sablintechno/O_C_T41/hardware/12HP_Panel+Expander/README.md

<h1>Front PCB</h1>
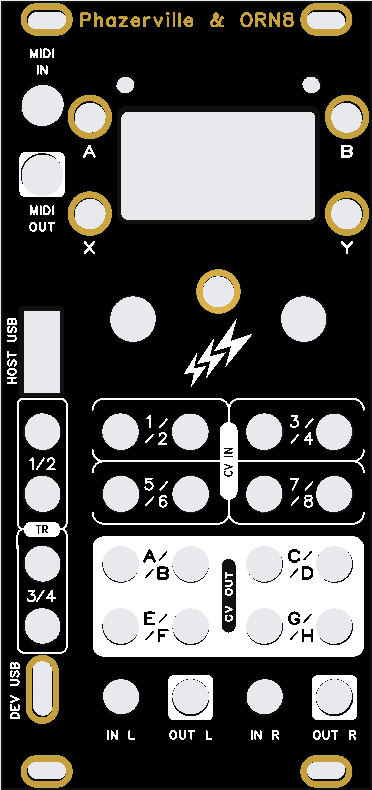
[picture p1: hardware/12HP_Panel+Expander/ornamant-crimes-o-r-n-8-phazervi.jpg]

<h1>Front</h1>
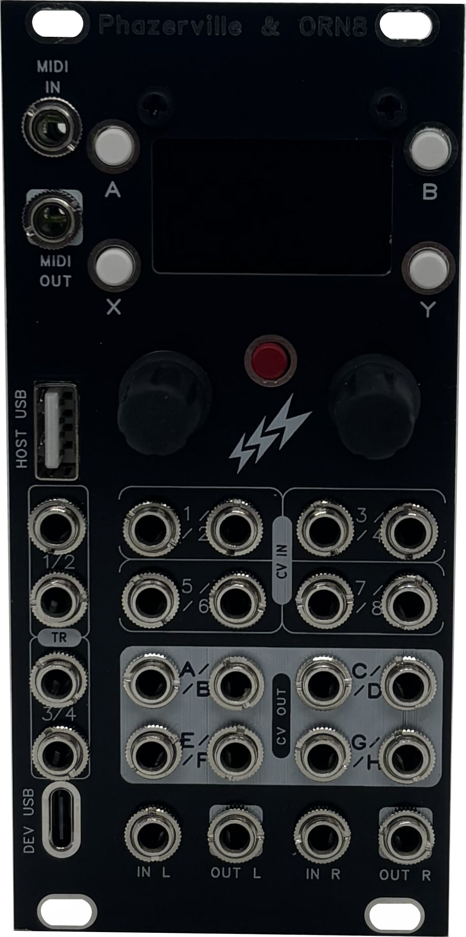
[picture p2: hardware/12HP_Panel+Expander/Pic_Front.png]

<h1>Side</h1>
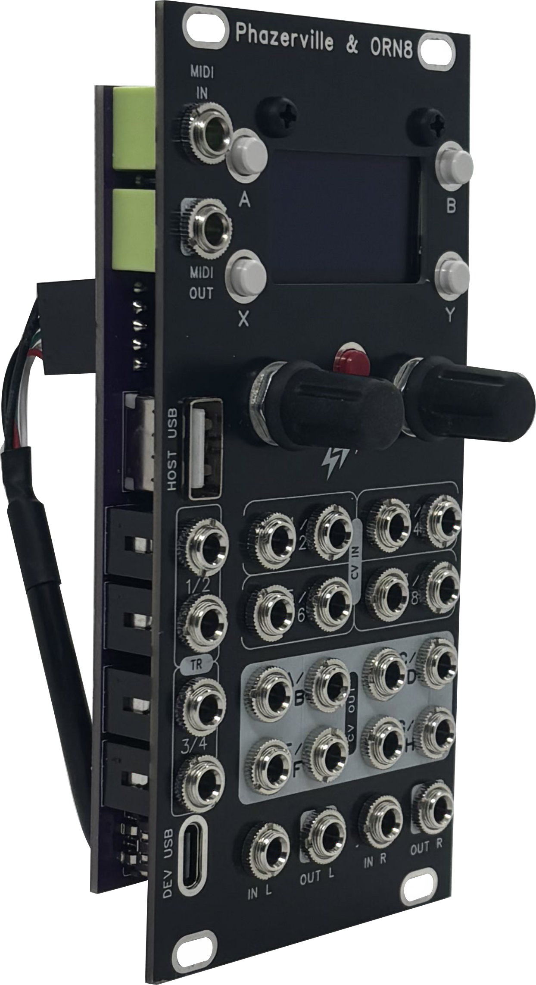
[picture p3: hardware/12HP_Panel+Expander/Pic_Side.png]
