sablintechno/O_C_T41/hardware/12HP_Panel+Expander/RM_O_C_T41_bottom_analog_bom.xlsx

Comment | Designator | Footprint | LCSC Part # |  | Original Part
22pF | C34, C35, C36, C37, C38, C39, C40, C41 | 0805 | C1804 | CL21C220JBANNNC | C105623 | CC0805JRNPO9BN220
47pF | C46, C47 | 0805 | C14857 | CL21C470JBANNNC | C107118 | CC0805JRNPO9BN470
470pF | C18, C19, C20, C21, C22, C23, C24, C25 | 0805 | C1822 | 0805CG471J500NT | C62771 | CC0805JRNPO9BN471
1nF | C44, C45 | 0805 | C1791 | CL21C102JBCNNNC | C16195506 | CL21C102JBCNFNC
8.2nF | C42, C43 | 0805 | C576998 | CC0805JRX7R0BB822 | C17348613 | GRM2195C2A822JA01D
10nF |  | 0805 | C24666 | 0805B103J500NT | C58456 | CC0805JRX7R9BB103
DNP | C2, C3, C4, C5, C6, C7, C8, C9, C10, C11, C12
0.1uF | C13, C14, C15, C16, C17, C26, C27, C28, C29, C30, C31, C32, C33 | 0805 | C29926 | 0805B104J500NT | C111492 | CC0805JRX7R9BB104
1.0uF | C1,C50, C51 | 0805 | C541528 | CC0805JKX7R9BB105 | C541528 | CC0805JKX7R9BB105
10uF | C48, C49 | 0805 | C15850 | CL21A106KAYNNNE | C307520 | CL21A106KOQNNNG
220 | R59, R60, R61, R62, R63, R64, R65, R66, R83, R84, R85, R86, R87, R88, R89, R90, R91, R92 | 0805 | C17557 | 0805W8F2200T5E | C114519 | RC0805FR-07220RL
470 | R17, R18, R19, R20, R21, R22, R9, R6, R10, R7, R8 | 0805 | C17710 | 0805W8F4700T5E | C114564 | RC0805FR-07470RL
1.40K | R93, R94 | 0805 | C17388 | 0805W8F1401T5E | C482967 | RC0805FR-071K4L
2.21K | R95, R96 | 0805 | C17518 | 0805W8F2211T5E | C137557 | RC0805FR-072K21L
3.48K | R97, R98 | 0805 | C72936 | 0805W8F3481T5E | C274007 | RC0805FR-073K48L
4.7K | R1, R2, R3, R4, R5, R11, R12, R13, R14, R15, R16, R23, R24, R25, R26 | 0805 | C17673 | 0805W8F4701T5E | C60816 | RC0805FR-074K7L
12k1 | R67, R68, R69, R70, R71, R72, R73, R74 | 0805 | C515725 | ARG05BTC2492 | C865327 | RT0805BRD0724K9L | mod DAC
20k | R101, R102 | 0805 | C17623 | 0805W8F3162T5E | C483116 | RC0805FR-0731K6L | mod input
49.9K | R51, R52, R53, R54, R55, R56, R57, R58 | 0805 | C469661 | RT0805BRD0749K9L | C469661 | RT0805BRD0749K9L
75K 1% | R43, R44, R45, R46, R47, R48, R49, R50 | 0805 | C136919 | RT0805BRD0775KL | C136919 | RT0805BRD0775KL
100K 1% | R27, R28, R29, R30, R99, R100 | 0805 | C149504 | 0805W8F1003T5E | C96346 | RC0805FR-07100KL
100K 0,1% | R35, R36, R37, R38, R39, R40, R41, R42, R75, R76, R77, R78, R79, R80, R81, R82 | 0805 | C56453 | TC0525B1003T5E | C122537 | RT0805BRD07100KL
1M | R31, R32, R33, R34 |  | C17514 | 0805W8F1004T5E | C107700 | RC0805FR-071ML
Voltage | U1 | SOIC14 | C74559 | LM339ADR | C74559 | LM339ADR
Dual | U2, U3, U4, U5 | SOIC8 | C116706 | MCP6002-I/SN | C116706 | MCP6002-I/SN
Dual | U6, U7, U8, U9 | SOIC8 | C545167 | OPA2172IDR | C545167 | OPA2172IDR
Dual | U10 | SOIC8 | C34047 | MCP6022-I/SN | C34047 | MCP6022-I/SN
Dual | U11 | SOIC8 | C2860714 | LM833DR | C2860714 | LM833DR
Optocoupler | U27 | DIP6 | C78588 | H11L1 | C78588 | H11L1
100K 1% | R105, R106, R107, R108 | 0805 | C149504 | 0805W8F1003T5E | C96346 | RC0805FR-07100KL
4.7K | R103, R104 | 0805 | C17673 | 0805W8F4701T5E | C60816 | RC0805FR-074K7L
J22, J23 | 2 | 7x2 | SLW-107-01-T-S |  | zu flach
J1-J20 | 20 | Jack, mono 3.5mm | PJ-301M
J21 | 1 | OLED Display, 1.3 inch, 7 Pin, 128 x 64 px
J26-J27 | 2 | Header, 16x1 | SLW-116-01-T-S
SW1-SW5 | 5 | Pushbutton | TL1105SPF100Q
 |  | Cap | 1RLGR
SW6-SW7 | 2 | Rotary Encoder | PEC11R-4220K-S0024, T18 | PEC11R-4220F-S0024, D-Shaft
 | 2 | 24 pin headers | PPTC241LFBN-RC
 | 2 | 24 pin sockets - CRITICAL: USE A SOCKET so Teensy is replaceable!
Optionales RAM Update Teensy
APS6404L_3SQR | IC, optional PSRAM, https://www.pjrc.com/store/psram.html
IS66WVS16M8FBLL-104NLI
