sablintechno/O_C_T41/hardware/12HP_Panel+Expander/RM_O_C_T41_bottom_control_bom.xlsx

Comment | Designator | Footprint | LCSC Part # |  |  | Original Part
22pF | C92 | 0805 | C1804 | CL21C220JBANNNC | C105623 | CC0805JRNPO9BN220
 | C81, C82, C83, C84, C85, C86, C87, C88, C89, C90 | 0805 | C1835 | 0805CG681J500NT | C107121 | CC0805JRNPO9BN681
10nF | C91 | 0805 | C24666 | 0805B103J500NT | C58456 | CC0805JRX7R9BB103
1.0uF | C69, C70, C71, C72, C73 | 0805 | C541528 | CC0805JKX7R9BB105 | C541528 | CC0805JKX7R9BB105
0.1uF | C52, C53, C54, C55, C56, C57, C58, C59, C60, C61, C62, C63, C64, C65, C66, C67, C68, C94 | 0805 | C29926 | 0805B104J500NT | C111492 | CC0805JRX7R9BB104
10uF | C74, C75, C76, C77, C78, C79, C80 | 0805 | C15850 | CL21A106KAYNNNE | C307520 | CL21A106KOQNNNG
10uF | C93 | 1206 | C7171 | TAJA106K016RNJ | C7171 | TAJA106K016RNJ
22uF | C95, C96, C97 | 1206 | C12891 | CL31A226KAHNNNE | C12891 | CL31A226KAHNNNE
Bridge Rectifier | D1 | TO-269AA | C52151 | HD01-T | C52151 | HD01-T
Diode Zener | D2, D3, D4 |  | C142361 | 1SMB5918BT3G | C142361 | 1SMB5918BT3G
Diode | D5 | SDO123 | C77978 | 1N4148W-TP | C77978 | 1N4148W-TP
Diode | D6 | SDO123 |  |  |  | BZT52B5V1S | mod 5V
PTC Fuse | F1 | 1812 | C12430 | MF-MSMF010-2 | C12430 | MF-MSMF010-2
Ferrite Bead | L1 | 0805 | C2441364 | HZ0805E601R-10 | C2441364 | HZ0805E601R-10
Inductor | L2 |  | C2921170 | BCIHP0420SC-100M | C2921170 | BCIHP0420SC-100M | LQH44NN100K03L | LQH44PH100MPRL | CY43-10UH | MDA4020-100M | IFSC1515AHER100M01
Inductor | L3 | 0805 | C223145 | BRC2012T1R5MD | C223145 | BRC2012T1R5MD
Mosfet | Q1, Q2 | SOT23 | C80498 | FDV303N | C80498 | FDV303N
0 | R144 | 0805 | C17477 | 0805W8F0000T5E | C17477 | 0805W8F0000T5E
75 | R141, R142, R143 | 1206 | C17987 | 1206W4F750JT5E | C4185489 | CRCW120675R0FKEAC
120 | R139, R140 | 1206 |  |  |  |  | mod 5V
100 | R103, R104, R105, R106, R107, R108, R109, R110, R111, R112, R113, R114, R115, R116, R117 | 0805 | C17408 | 0805W8F1000T5E | C105577 | RC0805FR-07100RL
220 | R118 | 0805 | C17557 | 0805W8F2200T5E | C114519 | RC0805FR-07220RL
470 | R119 | 0805 | C17710 | 0805W8F4700T5E | C114564 | RC0805FR-07470RL
1K | R131, R132 | 0603 | C21190 | 0603WAF1001T5E | C22548 | RC0603FR-071KL
5.11K 1% | R126 | 0805 | C46039 | 0805W8F5111T5E | C276311 | RC0805FR-075K11L
10K 0,005% | R133, R134, R135, R136, R137 | 0805 | C706400 | RT0805WRD0710KL | C2073470 | ERA-6ARW103V
4k7 | R133 | 0805 |  |  |  |  | mod DAC
5k8 | R134 | 0805 |  |  |  |  | mod DAC
4.7K 1% | R121, R123, R124, R120, R122 | 0805 | C17673 | 0805W8F4701T5E | C60816 | RC0805FR-074K7L
11K | R125 | 0805 | C17429 | 0805W8F1102T5E | C137597 | RC0805FR-0711KL
20K 0,05% | R138 | 0805 | C706402 | RT0805WRD0720KL | C4141407 | ERA-6ARW203V | AR05ATB2002 | PTFR0805Q20K0N9
22K | R128 | 0805 | C17560 | 0805W8F2202T5E | C114565 | RC0805FR-0722KL
27k | R127 | 0805 |  |  |  |  | mod 5V
150K 1% | R129 | 0805 | C17470 | 0805W8F1503T5E | C114558 | RC0805FR-07150KL
100K 1% | R130 | 0805 |  |  |  |  | mod HW
DNP | R200, R201, R202
Buck Converter | U13 | SOT-23-6 | C3193129 | LMR54406FDBVR | C3193129 | LMR54406FDBVR
LDO 5V | U14 | SOT-23-5 | C37560592 | LP2985A-50DBVRM3 | C37560592 | LP2985A-50DBVRM3 | LP2985-50DBVR
LDO 3.3V | U15 | SOT-23-5 | C2862740 | TPS7A2033PDBVR | C2862740 | TPS7A2033PDBVR
LDO 1.8V | U16 | SOT-23-5 | C92498 | LP5907MFX-1.8/NOPB | C92498 | LP5907MFX-1.8/NOPB
ADC | U17 | MSOP-10 | C635977 | MCP33131D-05-E/MS | C635977 | MCP33131D-05-E/MS
analog mux | U18 | TSSOP-16 | C547982 | 74LV4051PW,118 | C547982 | 74LV4051PW,118
DAC | U19 | TSSOP-16 | C2680013 | DAC8568IBPWR | C2680013 | DAC8568IBPWR
Buffer level shifter | U20, U21, U22, U23 | SOT-23-5 | C473338 | SN74LV1T125DBVR | C473338 | SN74LV1T125DBVR
Audio ADC | U24 | TSSOP-14 | C55513 | PCM1808PWR | C55513 | PCM1808PWR
Audio DAC | U25 | SSOP-16-150mil | C294211 | PCM1754DBQR | C294211 | PCM1754DBQR
Dual Opamp | U26 | SOIC-8 | C962986 | OPA2277UA | C962986 | OPA2277UA
Optocoupler | U27 | DIP6 | C78588 | H11L1 | C78588 | H11L1 | H11L1SVM
J38 | 1 | Connector, JST 4 pin, Sparkfun QWIIC |  |  |  | PRT-14417
J28-J29 | 2 | Socket, 7x2 (omit if soldering boards together) |  |  |  | TSW-107-06-T-S
J30-J31 | 2 | Socket, 16x1 (omit if soldering boards together) |  |  |  | TSW-116-06-T-S
J32 | 1 | Header, 5x2 Shrouded |  |  |  | 68015-405HLF
J33 | 1 | Header, 4x1 |  |  |  | 68000-204HLF
J34-J35 | 2 | Header, 2x1 (omit if debug signals not needed)
J36-J37 | 2 | Test Point (omit if not needed) Keystone 5011
U12 | 1 | Teensy 4.1 (with headers and sockets) |  |  |  | 16996
