sablintechno/O_C_T41/(list of files, drawings)

Other design files:
hardware/12HP_Panel+Expander/RM_analog_rev3_V0.1.dip
hardware/12HP_Panel+Expander/RM_control_rev3_V0.1.dip
hardware/12HP_Panel+Expander/RM_front_rev3_V0.1.dip
