sablintechno/O_C_T41/hardware/12HP_Panel+Expander/KiCad/RM_control_rev3_V0.1.kicad_pcb

## KiCad design hardware/12HP_Panel+Expander/KiCad/RM_control_rev3_V0.1.kicad_pcb (2026-06-14)

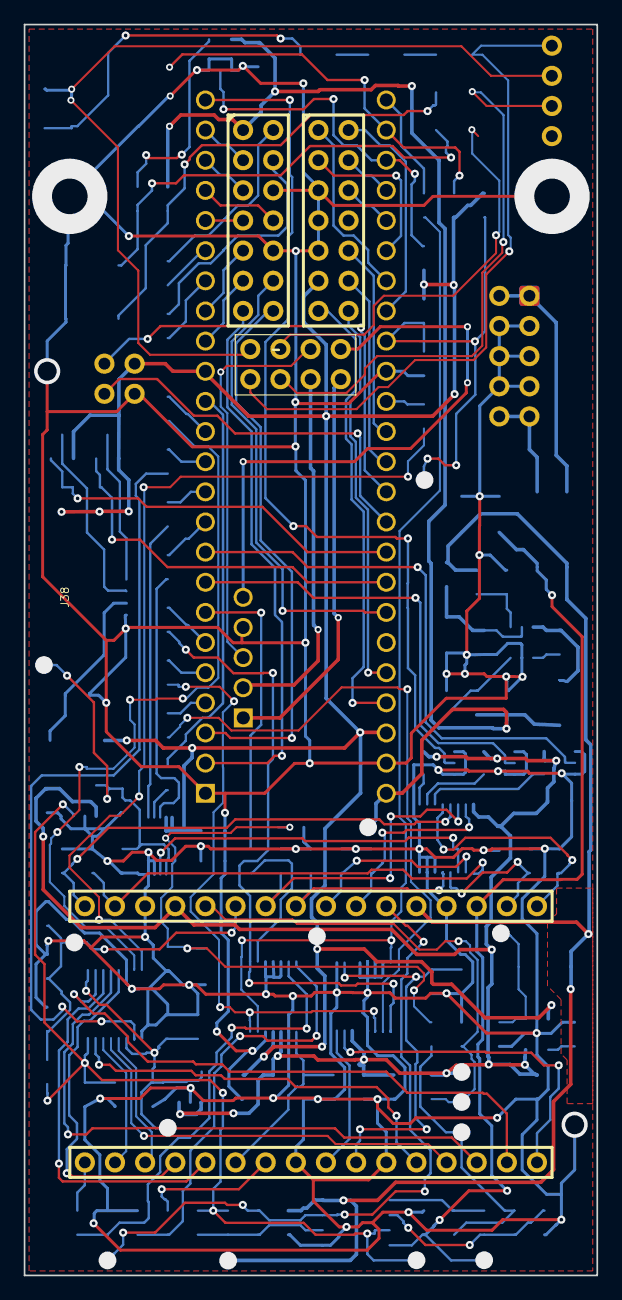
[picture p4: board RM_control_rev3_V0.1.kicad_pcb from above]

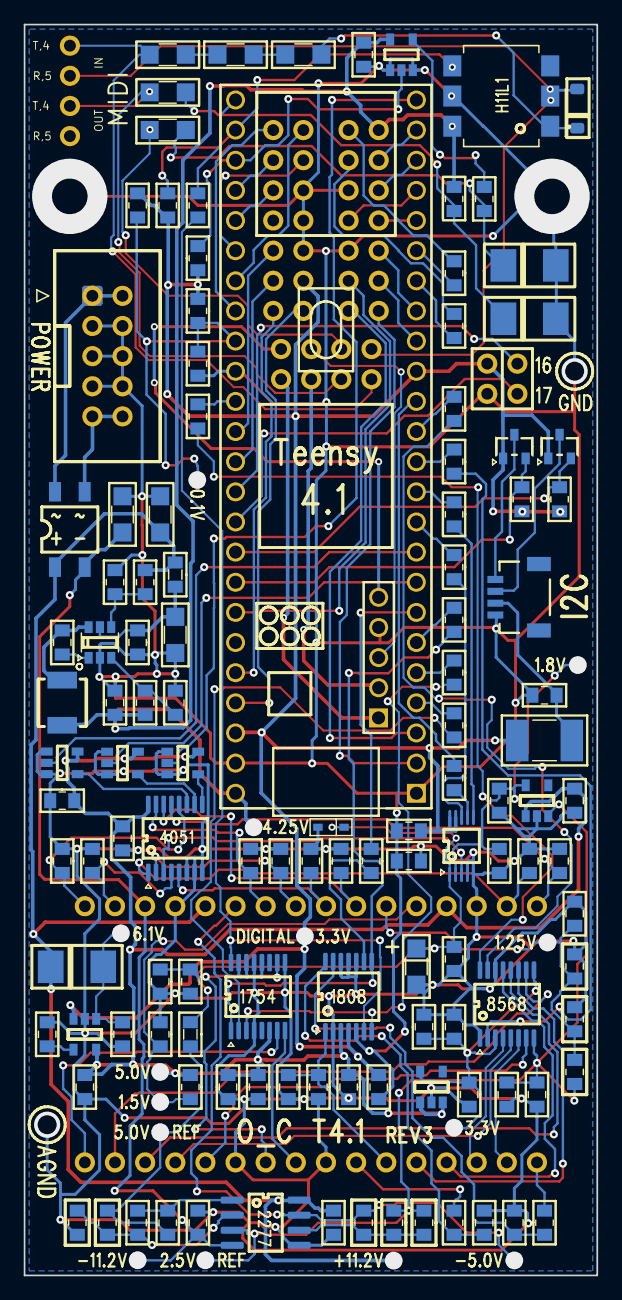
[picture p5: board RM_control_rev3_V0.1.kicad_pcb from below]

Board: 2 copper layers, 48.3 x 105.4 mm, 128 parts (2 on the bottom side), 126 nets.

Parts:
C52, C54, C57, C60, C61, C71, C73, C74, C81, C82, C83, C84, C85, C86, C87, C88, C89, C90, C91, C92: C_0805_2012METRIC_PAD1.18X1.45MM_HANDSOLDER_RECTP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; C_0805_2012Metric_Pad1.18x1.45mm_HandSolder_rectpads
C53, C55, C56, C58, C59, C62, C63, C64, C65, C66, C67, C68, C69, C70, C72, C75, C76, C77, C78, C79, C80, C94: C_0805_2012METRIC_PAD1.18X1.45MM_HANDSOLDER_RECTP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; C_0805_2012Metric_Pad1.18x1.45mm_HandSolder_rectpads_C53
C93, C97: C_1206_3216METRIC_PAD1.33X1.80MM_HANDSOLDER_RECTP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; C_1206_3216Metric_Pad1.33x1.80mm_HandSolder_rectpads
C95, C96: C_1206_3216METRIC_PAD1.33X1.80MM_HANDSOLDER_RECTP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; C_1206_3216Metric_Pad1.33x1.80mm_HandSolder_rectpads_C95
D1: DIODE_BRIDGE_REDUCED; Diode_Bridge_reduced
D2, D3, D4: D_SMB_HANDSOLDERING_RECTPADS; D_SMB_Handsoldering_rectpads
D5: D_SOD-123
D6: D_SOD-323F_RECTPADS; D_SOD-323F_rectpads
F1: FUSE_1812_4532METRIC_PAD1.30X3.40MM_HANDSOLDER_RE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; Fuse_1812_4532Metric_Pad1.30x3.40mm_HandSolder_rectpads
J1: PINSOCKET_1X04_P2.54MM_VERTICAL_REDUCED; PinSocket_1x04_P2.54mm_Vertical_reduced
J28, J29: PINSOCKET_2X07_P2.54MM_VERTICAL_REDUCED; PinSocket_2x07_P2.54mm_Vertical_reduced
J30, J31: PINSOCKET_1X16_P2.54MM_VERTICAL_REDUCED; PinSocket_1x16_P2.54mm_Vertical_reduced
J32: IDC-HEADER_2X05_P2.54MM_VERTICAL_REDUCED; IDC-Header_2x05_P2.54mm_Vertical_reduced
J33: PINSOCKET_2X04_P2.54MM_VERTICAL_REDUCED; PinSocket_2x04_P2.54mm_Vertical_reduced
J34: PINHEADER_2X02_P2.54MM_VERTICAL_SYMMETRIC; PinHeader_2x02_P2.54mm_Vertical_symmetric
J38: JST_SMD_1.0MM-4; JST_SMD_1.0mm-4
L1: L_0805_2012METRIC_RECTPADS; L_0805_2012Metric_rectpads
L2: L_ABRACON_ASPI-4030S_RECTPADS; L_Abracon_ASPI-4030S_rectpads
L3: L_0805_2012METRIC_RECTPADS; L_0805_2012Metric_rectpads_L3
Q1, Q2: SOT-23-3_RECTPADS; SOT-23-3_rectpads
R103, R104, R112, R119, R120, R122, R123, R124, R126, R127, R128, R131, R132, R133, R134, R136, R137, R138, R144, R200: R_0805_2012METRIC_PAD1.20X1.40MM_HANDSOLDER_RECTP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; R_0805_2012Metric_Pad1.20x1.40mm_HandSolder_rectpads
R105, R106, R107, R108, R109, R110, R111, R113, R114, R115, R116, R117, R118, R121, R125, R129, R130, R135, R201, R202: R_0805_2012METRIC_PAD1.20X1.40MM_HANDSOLDER_RECTP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; R_0805_2012Metric_Pad1.20x1.40mm_HandSolder_rectpads_R105
R139, R140, R141, R142, R143: R_1206_3216METRIC_PAD1.30X1.75MM_HANDSOLDER_RECTP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; R_1206_3216Metric_Pad1.30x1.75mm_HandSolder_rectpads
U12: TEENSY41; Teensy41
U13: SOT-23-6_RECTPADS; SOT-23-6_rectpads
U14: SOT-23-5_REDUCEDPADS; SOT-23-5_reducedpads
U15, U16, U20, U21, U22, U23: SOT-23-5_REDUCEDPADS; SOT-23-5_reducedpads_U15
U17: MSOP-10_3X3MM_P0.5MM_SILKSCREEN+FOOTPRINT; MSOP-10_3x3mm_P0.5mm_silkscreen+footprint
U18, U19, U25: TSSOP-16_4.4X5MM_P0.65MM_SILKSCREEN; TSSOP-16_4.4x5mm_P0.65mm_silkscreen
U24: TSSOP-14_4.4X5MM_P0.65MM_SILKSCREEN; TSSOP-14_4.4x5mm_P0.65mm_silkscreen
U26: SOIC-8_3.9X4.9MM_P1.27MM_SHIFTEDPADS; SOIC-8_3.9x4.9mm_P1.27mm_shiftedpads
U27: OPTOCOUPLER_H11F3SR2M

Connections:
+3v3: C57.1, C63.1, F1.2, J28.12, J34.1, Q1.1, Q2.1, R119.1, R120.1, R122.1, R123.1, R130.1, R202.1, U12.3.3V, U12.3.3V@, U14.3, U17.9, U17.10, U24.4
+4v: C74.1, C94.1, J29.2, L2.2, R116.1, R127.1, U12.VIN, U23.5, U27.6
+5va: C54.1, C55.1, C64.1, C66.1, C70.1, C72.1, C76.1, J30.4, R125.1, U14.5, U15.1, U15.3, U16.1, U18.16, U20.5, U21.5, U22.5, U24.3, U25.6
+12va: C67.1, C95.1, D1.1, D2.1, J30.12, L1.1, R129.1, U26.8
-12va: C68.2, C96.1, D1.2, J30.14, U26.4
/adc_cs: R107.1, U12.9
/adc_miso: R112.2, U12.12
/adc_mux_a0: U12.7, U20.2
/adc_mux_a1: U12.6, U21.2
/adc_mux_a2: U12.32, U22.2
/adc_sck: R108.1, U12.8
/dac_cs: R106.1, U12.10
/dac_mosi: R105.1, U12.11
/dac_sck: R114.1, U12.13
/debug1: J34.2, U12.16
/debug2: J34.4, U12.17
/enc_l_a: J29.4, U12.31
/enc_l_b: J29.6, U12.30
/enc_l_sw: J29.12, U12.24
/enc_r_a: J28.5, U12.37
/enc_r_b: J28.3, U12.36
/enc_r_sw: J29.10, U12.25
/hw_id: R121.1, R130.2, R202.2, U12.41
/i2c_scl: Q1.2, R122.2, U12.19
/i2c_sda: Q2.2, R123.2, U12.18
/i2s_bclk: R109.1, U12.4
/i2s_data_adc: R113.1, U12.5
/i2s_data_dac: R111.1, U12.2
/i2s_lrclk: R110.1, U12.3
/i2s_mclk: R115.1, U12.33
/midi_in: R119.2, U12.34, U27.4
/midi_out: R120.2, U12.35, U23.2
/oled_cs: J28.1, U12.40
/oled_dc: J28.2, U12.39
/oled_mosi: R104.1, U12.26
/oled_rst: J28.4, U12.38
/oled_sck: R103.1, U12.27
/sw_a: J29.7, U12.29
/sw_b: J28.9, U12.14
/sw_x: J29.8, U12.28
/sw_y: J28.11, U12.15
/sw_zap: J29.11, U12.20
/tr1: J29.14, U12.0
/tr2: J29.13, U12.1
/tr3: J28.14, U12.23
/tr4: J28.13, U12.22
D+_B: J33.6, U12.D+
D-_B: J33.5, U12.D-
SHLD_B: J33.8, U12.GND@_3
VBUS_B: J33.7, U12.+5V
earth: C53.2, C57.2, C63.2, C73.2, C74.2, C94.2, C95.2, C96.2, C97.2, D3.2, D4.2, J28.6, J28.8, J28.10, J29.5, J29.9, J32.3, J32.4, J32.5, J32.6, J32.7, J32.8, J34.3, J38.1, R121.2, R126.2, R128.2, R144.1, U12.GND, U12.GND@, U12.GND@_1, U12.GND@_2, U13.2, U23.1, U23.3, U24.5, U27.5
gnd: C54.2, C55.2, C56.2, C58.2, C59.2, C60.2, C61.2, C62.2, C64.2, C65.2, C66.2, C67.2, C68.1, C69.2, C70.2, C71.2, C72.2, C75.2, C76.2, C77.2, C78.2, C79.2, C80.2, C81.2, C82.2, C83.2, C84.2, C85.2, C86.2, C87.2, C88.2, C89.2, C90.2, C91.2, C93.2, D6.2, J30.3, J30.13, J31.8, J31.11, R124.2, R133.2, R136.1, R144.2, R200.2, U14.2, U15.2, U16.2, U17.4, U17.5, U18.6, U18.7, U18.8, U19.1, U19.14, U20.1, U20.3, U21.1, U21.3, U22.1, U22.3, U24.2, U24.10, U24.11, U24.12, U25.4, U25.9, U25.12, U25.13, U25.14, U25.15, U26.5
net-(c92-pad2): C92.2, R118.1, U26.1
net-(d2-a): C69.1, D2.2, U14.1
net-(d3-k): D3.1, R117.2, R140.1
net-(d4-k): D4.1, R116.2, R139.1
net-(d5-a): D5.2, J1.2, J33.2, U27.2
net-(d5-k): D5.1, R141.1, U27.1
net-(d6-k): C59.1, C93.1, D6.1, L3.2, U17.1
net-(j29-pin_1): J29.1, R103.2
net-(j29-pin_3): J29.3, R104.2
net-(j30-pin_1): C88.1, J30.1, U18.13
net-(j30-pin_2): C87.1, J30.2, U18.1
net-(j30-pin_5): J30.5, R124.1, R125.2
net-(j30-pin_6): C61.1, J30.6, R133.1, R134.2, R200.1
net-(j30-pin_7): C86.1, J30.7, U18.14
net-(j30-pin_8): C85.1, J30.8, U18.5
net-(j30-pin_9): C84.1, J30.9, U18.2
net-(j30-pin_10): C83.1, J30.10, U18.15
net-(j30-pin_11): J30.11, R138.2, U26.7
net-(j30-pin_15): C82.1, J30.15, U18.4
net-(j30-pin_16): C81.1, J30.16, U18.12
net-(j31-pin_1): J31.1, R132.2
net-(j31-pin_2): J31.2, U19.6
net-(j31-pin_3): J31.3, U19.4
net-(j31-pin_4): J31.4, U19.13
net-(j31-pin_5): J31.5, U19.11
net-(j31-pin_6): C65.1, C77.1, J31.6, U24.1
net-(j31-pin_7): J31.7, R131.2
net-(j31-pin_9): J31.9, U25.8
net-(j31-pin_10): C56.1, C75.1, J31.10, U25.10
net-(j31-pin_12): J31.12, U19.7
net-(j31-pin_13): J31.13, U19.5
net-(j31-pin_14): J31.14, U19.12
net-(j31-pin_15): J31.15, U19.10
net-(j31-pin_16): J31.16, U25.7
net-(j32-pin_1): D1.3, J32.1, J32.2
net-(j32-pin_10): D1.4, J32.9, J32.10
net-(j33-pin_1): J1.1, J33.1, R143.2
net-(j33-pin_3): J1.3, J33.3, R139.2
net-(j33-pin_4): J1.4, J33.4, R140.2
net-(j38-pin_2): C73.1, F1.1, J38.2
net-(j38-pin_3): J38.3, Q2.3
net-(j38-pin_4): J38.4, Q1.3
net-(l3-pad1): L3.1, R118.2, R137.2
net-(r141-pad2): R141.2, R142.1
net-(r142-pad2): R142.2, R143.1
net-(u13-cb): C52.1, U13.1
net-(u13-en): R128.1, R129.2, U13.4
net-(u13-fb): R126.1, R127.2, U13.3
net-(u13-sw): C52.2, L2.1, U13.6
net-(u13-vin): C53.1, C97.1, L1.2, U13.5
net-(u14-bp): C91.1, U14.4
net-(u15-out): C60.1, C71.1, C78.1, U15.5, U19.3, U19.9
net-(u16-en): C62.1, C79.1, R134.1, R135.1, R201.1, U16.3, U19.8, U26.3
net-(u16-out): C58.1, C80.1, U16.5, U17.2
net-(u17-ain+): U17.3, U18.3
net-(u17-cnvst): R107.2, U17.6
net-(u17-sclk): R108.2, U17.8
net-(u17-sdo): R112.1, U17.7
net-(u18-s0): U18.11, U20.4
net-(u18-s1): U18.10, U21.4
net-(u18-s2): U18.9, U22.4
net-(u19-din): R105.2, U19.15
net-(u19-sclk): R114.2, U19.16
net-(u19-~sync): R106.2, U19.2
net-(u23-y): R117.1, U23.4
net-(u24-bck): R109.2, U24.8, U25.1
net-(u24-dout): R113.2, U24.9
net-(u24-lrck): R110.2, U24.7, U25.3
net-(u24-scki): R115.2, U24.6, U25.16
net-(u24-vinl): C90.1, R132.1, U24.13
net-(u24-vinr): C89.1, R131.1, U24.14
net-(u25-data): R111.2, U25.2
net-(u26a--): C92.1, R136.2, R137.1, U26.2
net-(u26b--): R135.2, R138.1, R201.2, U26.6
