sablintechno/O_C_T41/hardware/12HP_Panel+Expander/KiCad/RM_analog_rev3V0.1.kicad_pcb

## KiCad design hardware/12HP_Panel+Expander/KiCad/RM_analog_rev3V0.1.kicad_pcb (2026-06-14)

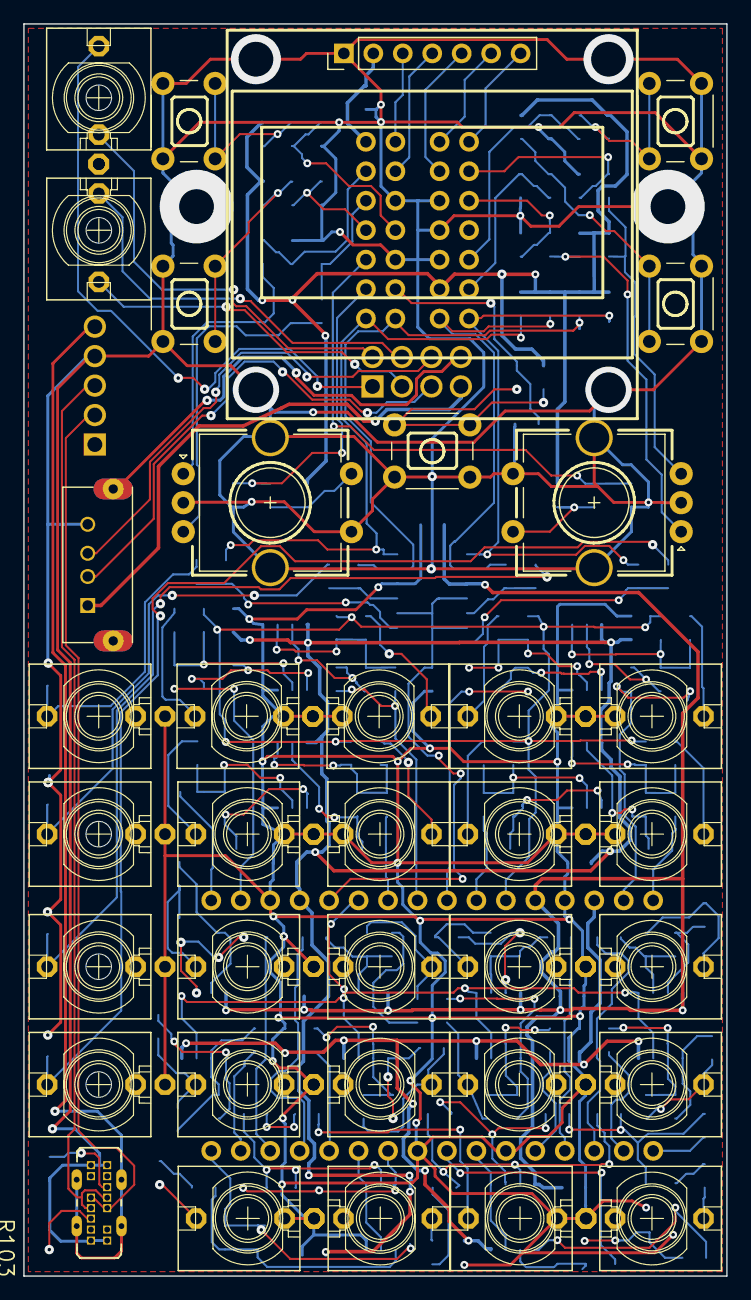
[picture p6: board RM_analog_rev3V0.1.kicad_pcb from above]

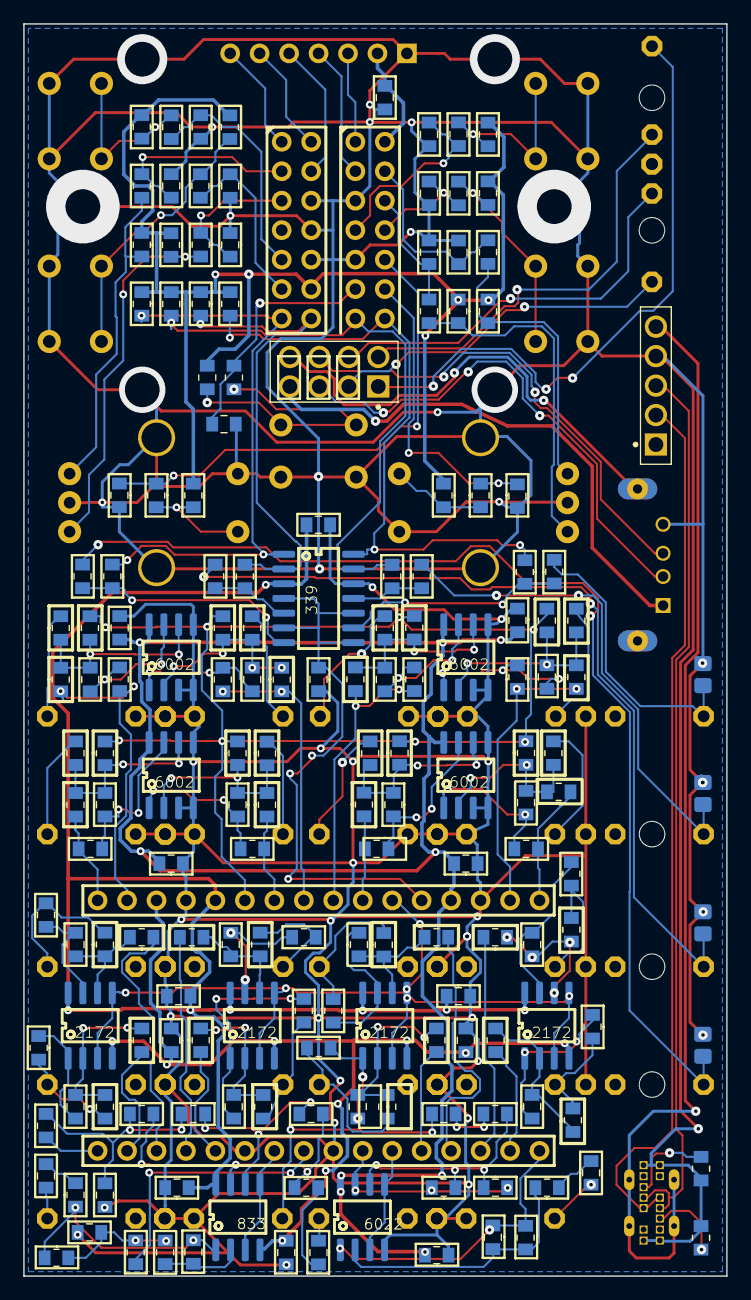
[picture p7: board RM_analog_rev3V0.1.kicad_pcb from below]

Board: 2 copper layers, 60.6 x 108.0 mm, 212 parts (6 on the bottom side), 148 nets.

Parts:
C1, C2, C3, C4, C5, C11, C12, C26, C28, C30, C34, C35, C36, C37, C48, C50: C_0805_2012METRIC_PAD1.18X1.45MM_HANDSOLDER_RECTP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; C_0805_2012Metric_Pad1.18x1.45mm_HandSolder_rectpads
C6, C7, C8, C9, C10, C13, C14, C15, C16, C17, C18, C19, C20, C21, C22, C23, C24, C25, C27, C29, C31, C32, C33, C38, C39, C40, C41, C42, C43, C44, C45, C46, C47, C49, C51: C_0805_2012METRIC_PAD1.18X1.45MM_HANDSOLDER_RECTP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; C_0805_2012Metric_Pad1.18x1.45mm_HandSolder_rectpads_C6
J1: DEV_J1; P51
J2: DEV_J2; P51
J3: DEV_J3; P51
J4, J8: JACK O_C; Jack_O_C
J5: DEV_J5; P51
J6: DEV_J6; P51
J7: DEV_J7; P51
J9: DEV_J9; P51
J10: DEV_J10; P51
J11: DEV_J11; P51
J12: DEV_J12; P51
J13: DEV_J13; P51
J14: DEV_J14; P51
J15: DEV_J15; P51
J16: DEV_J16; P51
J17: DEV_J17; P51
J18: DEV_J18; P51
J19: DEV_J19; P51
J20: DEV_J20; P51
J21: PINHEADER_1X07_P2.54MM_VERTICAL; PinHeader_1x07_P2.54mm_Vertical
J22, J23: PINHEADER_2X07_P2.54MM_VERTICAL_REDUCED; PinHeader_2x07_P2.54mm_Vertical_reduced
J24: RHDRV8W80P254_4X2_1066X508H865_AP1
J25: RHDRV5W80P254_5X1_1320X250H875_AP1
J26, J27: PINHEADER_1X16_P2.54MM_VERTICAL_REDUCED; PinHeader_1x16_P2.54mm_Vertical_reduced
MIDI_IN0: DEV_MIDI_IN; P78
MIDI_OUT0: DEV_MIDI_OUT; P78
R1, R2, R3, R4, R5, R10, R11, R12, R13, R14, R15, R16, R23, R24, R25, R26, R27, R28, R29, R30, R35, R36, R37, R38, R39, R40, R41, R42, R51, R52, R53, R54, R55, R56, R57, R58, R59, R60, R61, R62, R79, R80, R81, R82, R83, R87, R89, R90, R101: R_0805_2012METRIC_PAD1.20X1.40MM_HANDSOLDER_RECTP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; R_0805_2012Metric_Pad1.20x1.40mm_HandSolder_rectpads
R6, R7, R8, R9, R17, R18, R19, R20, R21, R22, R31, R32, R33, R34, R43, R44, R45, R46, R47, R48, R49, R50, R63, R64, R65, R66, R67, R68, R69, R70, R71, R72, R73, R74, R75, R76, R77, R78, R84, R85, R86, R88, R91, R92, R93, R94, R95, R96, R97, R98, R99, R100, R102: R_0805_2012METRIC_PAD1.20X1.40MM_HANDSOLDER_RECTP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; R_0805_2012Metric_Pad1.20x1.40mm_HandSolder_rectpads_R6
R103: 4k7; R_0805_2012Metric_Pad1.20x1.40mm_HandSolder_rectpads_R103
R104: 4k7; R_0805_2012Metric_Pad1.20x1.40mm_HandSolder_rectpads_R104
R105, R106, R107, R108: 100K; RES_0805
SW1, SW2, SW3, SW4, SW5: SW_PUSH_6MM; SW_PUSH_6mm
SW6, SW7: ROTARYENCODER_ALPS_EC11E-SWITCH_VERTICAL_H20MM_CI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; RotaryEncoder_Alps_EC11E-Switch_Vertical_H20mm_CircularMoun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
TR1: DEV_TR1; P51
TR2: DEV_TR2; P78
TR3: DEV_TR3; P78
TR4: DEV_TR4; P78
U1: SOIC-14_3.9X8.7MM_P1.27MM_SHIFTEDPADS; SOIC-14_3.9x8.7mm_P1.27mm_shiftedpads
U2, U3, U4, U5, U6, U7, U8, U9, U10, U11: SOIC-8_3.9X4.9MM_P1.27MM_SHIFTEDPADS; SOIC-8_3.9x4.9mm_P1.27mm_shiftedpads
USB_A0: USB_A_ALIEXPRESS_VERTICAL; USB_A_AliExpress_Vertical
USB_C0: SPARKFUN USB-C VERTICAL; SparkFun_USB-C_Vertical

Connections:
+3v3: J23.12, R1.1, R2.1, R3.1, R4.1, R5.1, R11.1, R12.1, R13.1, R14.1, R15.1, R16.1, R23.1, R24.1, R25.1, R26.1
+5va: C14.1, C15.1, C16.1, C17.1, C31.1, J26.4, U2.8, U3.8, U4.8, U5.8, U10.8
+12va: C13.1, C27.1, C29.1, C32.1, J26.12, U1.3, U6.8, U7.8, U8.8, U9.8, U11.8
-12va: C28.2, C30.2, C33.2, J26.14, U6.4, U7.4, U8.4, U9.4, U11.4
/audio_in_l: C46.1, J27.1, R101.2, U10.1
/audio_in_r: C47.1, J27.7, R102.2, U10.7
/audio_out_l: J27.16, R93.1
/audio_out_r: J27.9, R94.1
/bias: J26.6, U6.3, U6.5, U7.3, U7.5, U8.3, U8.5, U9.3, U9.5
/clk: J21.3, J22.1
/cs: J21.7, J23.1
/cv1: J26.2, R51.2, R59.2
/cv2: J26.8, R52.2, R60.2
/cv3: J26.9, R53.2, R61.2
/cv4: J26.15, R54.2, R62.2
/cv5: J26.1, R55.2, R63.2
/cv6: J26.7, R56.2, R64.2
/cv7: J26.10, R57.2, R65.2
/cv8: J26.16, R58.2, R66.2
/cv_a: J27.3, R67.1
/cv_b: J27.4, R68.1
/cv_c: J27.13, R69.1
/cv_d: J27.14, R70.1
/cv_e: J27.2, R71.1
/cv_f: J27.5, R72.1
/cv_g: J27.12, R73.1
/cv_h: J27.15, R74.1
/dac_a: J9.T, R75.2, R83.2
/dac_b: J10.T, R76.2, R84.2
/dac_c: J11.T, R77.2, R85.2
/dac_d: J12.T, R78.2, R86.2
/dac_e: J13.T, R79.2, R87.2
/dac_f: J14.T, R80.2, R88.2
/dac_g: J15.T, R81.2, R89.2
/dac_h: J16.T, R82.2, R90.2
/dc: J21.6, J23.2
/offset: J26.11, R43.2, R44.2, R45.2, R46.2, R47.2, R48.2, R49.2, R50.2
/res: J21.5, J23.4
/sda: J21.4, J22.3
/thres: C26.1, J26.5, U1.4, U1.6, U1.8, U1.10
/tr1: J22.14, R23.2, R31.2, U1.14
/tr2: J22.13, R24.2, R32.2, U1.13
/tr3: J23.14, R25.2, R33.2, U1.2
/tr4: J23.13, R26.2, R34.2, U1.1
/vcc: C1.1, J21.2, J22.2
D+_B: J24.6, USB_A0.3
D+_C: J25.3, USB_C0.A6, USB_C0.B6
D-_B: J24.5, USB_A0.2
D-_C: J25.2, USB_C0.A7, USB_C0.B7
Net_141: R103.2, USB_C0.B5
Net_142: R104.1, USB_C0.A5
SHLD: J25.5, USB_C0.S1, USB_C0.S1@, USB_C0.S1@_1, USB_C0.S1@_2
SHLD_B: J24.8, USB_A0.5, USB_A0.5@
VBUS_B: J24.7, USB_A0.1
earth: C1.2, C2.2, C3.2, C4.2, C5.2, C6.2, C7.2, C8.2, C9.2, C10.2, C11.2, C12.2, J21.1, J22.5, J22.9, J23.6, J23.8, J23.10, J25.4, R103.1, R104.2, R105.2, R106.2, R107.2, R108.2, SW1.1, SW1.1@, SW2.1, SW2.1@, SW3.1, SW3.1@, SW4.1, SW4.1@, SW5.1, SW5.1@, SW6.C, SW6.MP, SW6.MP@, SW6.S2, SW7.C, SW7.MP, SW7.MP@, SW7.S2, USB_A0.4, USB_C0.A1, USB_C0.A12, USB_C0.B1, USB_C0.B12
gnd: C13.2, C14.2, C15.2, C16.2, C17.2, C26.2, C27.2, C28.1, C29.2, C30.1, C31.2, C32.2, C33.1, C42.1, C43.1, J1.S, J1.TN, J2.S, J2.TN, J3.S, J3.TN, J4.S, J4.TN, J5.S, J5.TN, J6.S, J6.TN, J7.S, J7.TN, J8.S, J8.TN, J9.S, J10.S, J11.S, J12.S, J13.S, J14.S, J15.S, J16.S, J17.S, J17.TN, J18.S, J19.S, J19.TN, J20.S, J26.3, J26.13, J27.8, J27.11, TR1.S, TR2.S, TR3.S, TR4.S, U1.12, U2.3, U2.4, U2.5, U3.3, U3.4, U3.5, U4.3, U4.4, U4.5, U5.3, U5.4, U5.5, U10.4
net-(c18-pad1): C18.1, R59.1, U2.1
net-(c19-pad1): C19.1, R60.1, U2.7
net-(c20-pad1): C20.1, R61.1, U3.1
net-(c21-pad1): C21.1, R62.1, U3.7
net-(c22-pad1): C22.1, R63.1, U4.1
net-(c23-pad1): C23.1, R64.1, U4.7
net-(c24-pad1): C24.1, R65.1, U5.1
net-(c25-pad1): C25.1, R66.1, U5.7
net-(c34-pad1): C34.1, R83.1, U6.7
net-(c35-pad1): C35.1, R84.1, U7.7
net-(c36-pad1): C36.1, R85.1, U8.7
net-(c37-pad1): C37.1, R86.1, U9.7
net-(c38-pad1): C38.1, R87.1, U6.1
net-(c39-pad1): C39.1, R88.1, U7.1
net-(c40-pad1): C40.1, R89.1, U8.1
net-(c41-pad1): C41.1, R90.1, U9.1
net-(c42-pad2): C42.2, R93.2, R95.1, R97.2
net-(c43-pad2): C43.2, R94.2, R96.1, R98.2
net-(c44-pad2): C44.2, R91.1, R97.1, U11.7
net-(c45-pad2): C45.2, R92.1, R98.1, U11.1
net-(c48-pad1): C48.1, J18.T
net-(c48-pad2): C48.2, R91.2
net-(c49-pad1): C49.1, J20.T
net-(c49-pad2): C49.2, R92.2
net-(c50-pad1): C50.1, R99.1
net-(c50-pad2): C50.2, J17.T
net-(c51-pad1): C51.1, R100.1
net-(c51-pad2): C51.2, J19.T
net-(d5-a): J24.2, MIDI_IN0.TN
net-(j5-padt): J5.T, R39.1
net-(j6-padt): J6.T, R40.1
net-(j7-padt): J7.T, R41.1
net-(j8-padt): J8.T, R42.1
net-(j22-pin_4): C7.1, J22.4, R17.2
net-(j22-pin_6): C8.1, J22.6, R18.2
net-(j22-pin_7): C2.1, J22.7, R6.1
net-(j22-pin_8): C3.1, J22.8, R7.1
net-(j22-pin_10): C12.1, J22.10, R22.2
net-(j22-pin_11): C6.1, J22.11, R10.1
net-(j22-pin_12): C11.1, J22.12, R21.2
net-(j23-pin_3): C10.1, J23.3, R20.2
net-(j23-pin_5): C9.1, J23.5, R19.2
net-(j23-pin_9): C4.1, J23.9, R8.1
net-(j23-pin_11): C5.1, J23.11, R9.1
net-(j24-pin_1): R27.1, R105.1, TR1.T
net-(j24-pin_3): R28.1, R108.1, TR2.T
net-(j25-pin_1): R29.1, R106.1, TR3.T
net-(j25-pin_3): R30.1, R107.1, TR4.T
net-(j27-pin_6): J27.6, U10.3, U10.5
net-(j27-pin_10): J27.10, U11.3, U11.5
net-(j33-pin_1): J24.1, MIDI_IN0.T
net-(j33-pin_3): J24.3, MIDI_OUT0.T
net-(j33-pin_4): J24.4, MIDI_OUT0.TN
net-(jp1-b): J1.T, R35.1
net-(jp2-b): J2.T, R36.1
net-(jp3-b): J3.T, R37.1
net-(jp4-b): J4.T, R38.1
net-(r1-pad2): R1.2, R6.2, SW1.2, SW1.2@
net-(r2-pad2): R2.2, R7.2, SW2.2, SW2.2@
net-(r3-pad2): R3.2, R8.2, SW3.2, SW3.2@
net-(r4-pad2): R4.2, R9.2, SW4.2, SW4.2@
net-(r10-pad2): R5.2, R10.2, SW5.2, SW5.2@
net-(r11-pad2): R11.2, R17.1, SW6.A
net-(r12-pad2): R12.2, R18.1, SW6.B
net-(r13-pad2): R13.2, R19.1, SW7.A
net-(r14-pad2): R14.2, R20.1, SW7.B
net-(r15-pad2): R15.2, R21.1, SW6.S1
net-(r16-pad2): R16.2, R22.1, SW7.S1
net-(u1a-+): R29.2, R33.1, U1.5
net-(u1b-+): R30.2, R34.1, U1.7
net-(u1c-+): R28.2, R32.1, U1.11
net-(u1d-+): R27.2, R31.1, U1.9
net-(u2a--): C18.2, R35.2, R43.1, R51.1, U2.2
net-(u2b--): C19.2, R36.2, R44.1, R52.1, U2.6
net-(u3a--): C20.2, R37.2, R45.1, R53.1, U3.2
net-(u3b--): C21.2, R38.2, R46.1, R54.1, U3.6
net-(u4a--): C22.2, R39.2, R47.1, R55.1, U4.2
net-(u4b--): C23.2, R40.2, R48.1, R56.1, U4.6
net-(u5a--): C24.2, R41.2, R49.1, R57.1, U5.2
net-(u5b--): C25.2, R42.2, R50.1, R58.1, U5.6
net-(u6a--): C38.2, R71.2, R79.1, U6.2
net-(u6b--): C34.2, R67.2, R75.1, U6.6
net-(u7a--): C39.2, R72.2, R80.1, U7.2
net-(u7b--): C35.2, R68.2, R76.1, U7.6
net-(u8a--): C40.2, R73.2, R81.1, U8.2
net-(u8b--): C36.2, R69.2, R77.1, U8.6
net-(u9a--): C41.2, R74.2, R82.1, U9.2
net-(u9b--): C37.2, R70.2, R78.1, U9.6
net-(u10a--): C46.2, R99.2, R101.1, U10.2
net-(u10b--): C47.2, R100.2, R102.1, U10.6
net-(u11a--): C45.1, R96.2, U11.2
net-(u11b--): C44.1, R95.2, U11.6
