sablintechno/O_C_T41/(commit log)

2026-06-08 Add BOM & CPL
    [RM_O_C_T41_bottom_analog_bom.xlsx, RM_O_C_T41_bottom_control_bom.xlsx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]
2026-06-14 Create KiCad
2026-06-14 add kicad files
    [RM_analog_rev3V0.1.kicad_pcb, RM_control_rev3_V0.1.kicad_pcb]
